leiemm/emm2025/viewer of robot v2.0/right.jpg

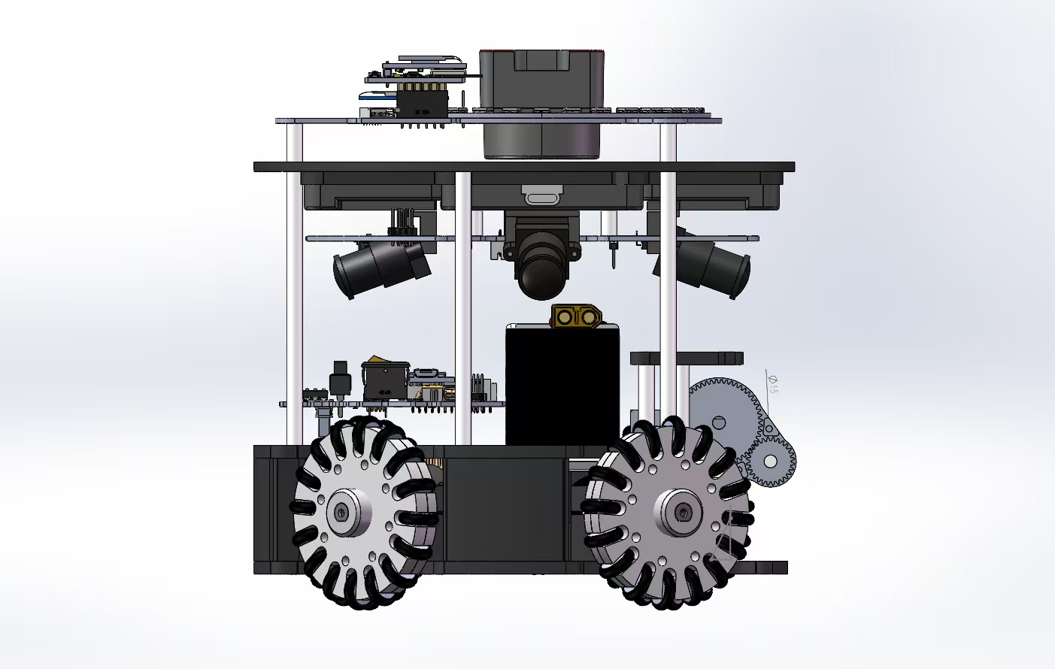
viewer of robot v2.0/right.jpg
