leiemm/emm2025/viewer of robot v2.0/overall.jpg

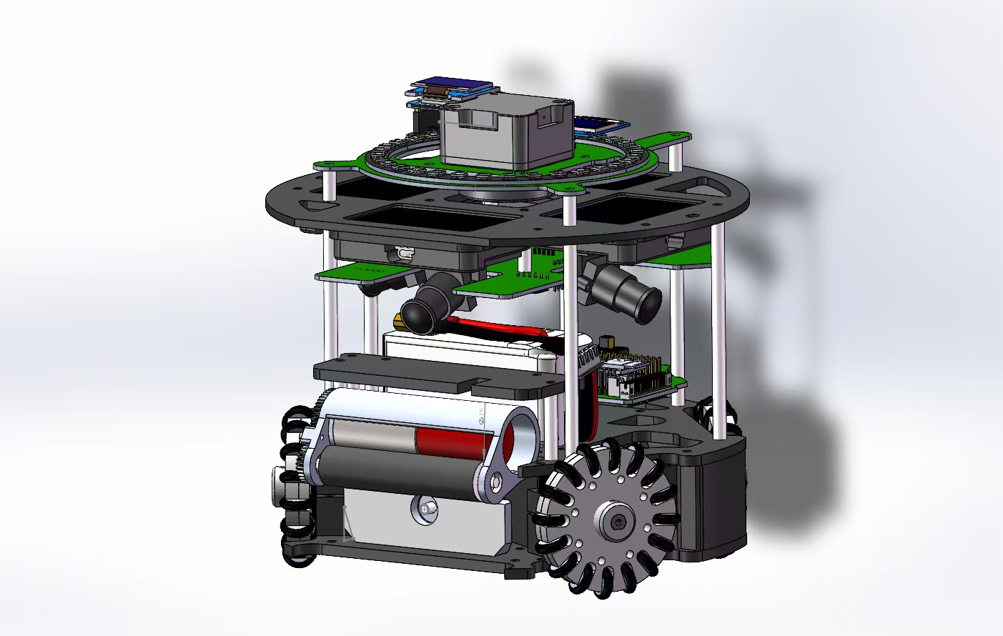
viewer of robot v2.0/overall.jpg
