leiemm/emm2025/poster/2026Korea.pdf

Others

# Soccer Vison

## E M M - S O C C E R

# E S C O L A D O S M O R A D O R E S D E M A C A U

Experiment / DATA

### Dribbler system

- Motor
- Micro Switch
- Gear *2
- Roller stick
- Rubber

### Positioning module

- YDLIDAR T-mini Plus

A

### Kicker system

- self made
electromagnet
- Custom MOSFET
Drive Circuit

When the robot touches our restricted area (sideline and restricted area), we decompose the speed into the x-axis and y-axis components, then cancel the out-ofbounds direction and re-synthesize to get the final speed.

# Out of bounds

Establish a circle as a defensive movement trajectory, and stay on the line connecting the ball and the center of the goal, limiting the opponent's maximum offensive space, with the head always facing outward.When the ball is stationary, it will dribble and then shoot the ball towards the goal.

# Deffense

攻

守

### Omni wheel *4

# Kicker system

## - Experiments & Data of Custom Electromagnet

# Omnidirectional positioning system

## -Use and development of lidar

We have achieved full-field localization based on LiDAR.
The system collects environmental point cloud data via
LiDAR and integrates gyroscope attitude data to correct each reflection point. All valid points are scored and voted on in both horizontal and vertical directions, and the four highest-scoring line segments are extracted to construct the complete field boundary. Simultaneously, LiDAR can detect scattered interference points in the field and calculate the real-time coordinates of enemy robots, providing reliable positional information for strategic decision-making. Our two robots communicate via Bluetooth, sharing their own status. By filtering out point cloud interference generated by the teammate robot, stable and accurate enemy coordinate localization is achieved.

# Long-distance vision system

## -Use of 4 cameras

# Speed control system

## -Use of PID Regulation

We conducted in-depth research on the coil and even built one ourselves. We found that increasing the current gain seemed to be greater than increasing the number of turns. Through derivation and testing, we determined the complete manufacturing process. Flat enameled wire was used for the winding to improve space utilization, and the coil resistance was verified using a milliohm meter after winding.
We developed a dedicated MOS drive circuit for this highpower coil. High-current MOSFETs have large parasitic capacitances; we added a push-pull circuit to accelerate the gate charging and discharging speed, avoiding MOSFET thermal breakdown due to switching losses during ramp-up. An external Schottky diode was used to prevent backflip, and VGS and current were monitored in real-time using an oscilloscope. A fuse was also installed for fault protection. Drawings and circuit diagrams are available on GitHub.
To standardize the experiments, we built a portable velocity measurement device. The flight time of a golf ball between two fixed laser beams was recorded, and its launch velocity was calculated to quantify the electromagnetic output performance. Currently, our electromagnet can achieve a velocity of approximately 3.8 m/s on this device.

### Battery

- Lipo(6s 22.2V 1450mah 180C)

### Motor system

- DJI robimaster M2006 motor *4
- DJI robimaster C615 ESC *4
- Adafruit CAN Pal *1

# Offense

### Main borad

- Teensy4.1

After holding the
ball, detect the
gap in the goal
and quickly shoot
the ball to the
goal.

E

F

G
H

I

We are a Macau team participating in soccer Vison. Our team this year consists of three high school students. This year, we have made major changes to our bodies. We hope to play exciting games on the field, communicate with other players, and make progress together.

Strategy

B

then turn around and shoot the goal.

C
D

### Visual system

- MaixCAM *4

ABSTRACT

LEI PUI WA
YE CHON KIT
SIT IONG / LAO SENG

Hardware/Software
Software
Electricity

## REGION

# MACAU, CHINA

## LEAGUE

Team members

### UI Circuit

- Ssd1306
- Ws2812 32bit

Overall

## Robot's Structure

Our robot design was completed in SOLIDWORKS, with the main body 3D printed using high-strength PETG wire. The PCB circuit design was completed in JLC EDA. We designed four cameras and used LiDAR for full-field anti-interference positioning and enemy detection, which enabled us to obtain good field data and more accurate sphere information, and to achieve diverse offensive and defensive postures.

Dribble along the
sideline, approach
the penalty area with
your back to the
opponent's
goalkeeper,

Bambu Lab
X1C

# Environment

GitHub
resources

Youtube channel:
https://youtube.com/@emm-soccer GitHub:
https://github.com/leiemm/emm2025

（The video can be found on our YouTube channel.）

Design / Algorithms

10-millisecond cycle
current detection

Hand-wound coil

drive circuit

Speed measuring device

Our robot is equipped with four cameras to deliver allround vision, expanding ball detection range and eliminating visual blind spots.
We use tangent circular trajectories to orbit the ball, enabling the shortest moving path while facing the goal. We set a virtual circle around the ball and compute distances and steering angles with right triangle geometry and inverse trigonometric functions. Calculation details are shown in the attached figure.

The robot’s field movement speed is regulated via PID control for both linear and angular velocity. When the robot moves forward without shortening its distance to the ball, the controller automatically increases speed to approach faster.
Meanwhile, variable dribble speed is implemented: the dribbler’s speed adjusts dynamically with the robot’s angular velocity to prevent ball loss during rotation.
Relationship Diagram of Dribbler Speed and Robot Motion Speed
