leiemm/emm2025/CAD drawing/3Ddrawing(robot)/PCB/Sub broad _robot2.0.png

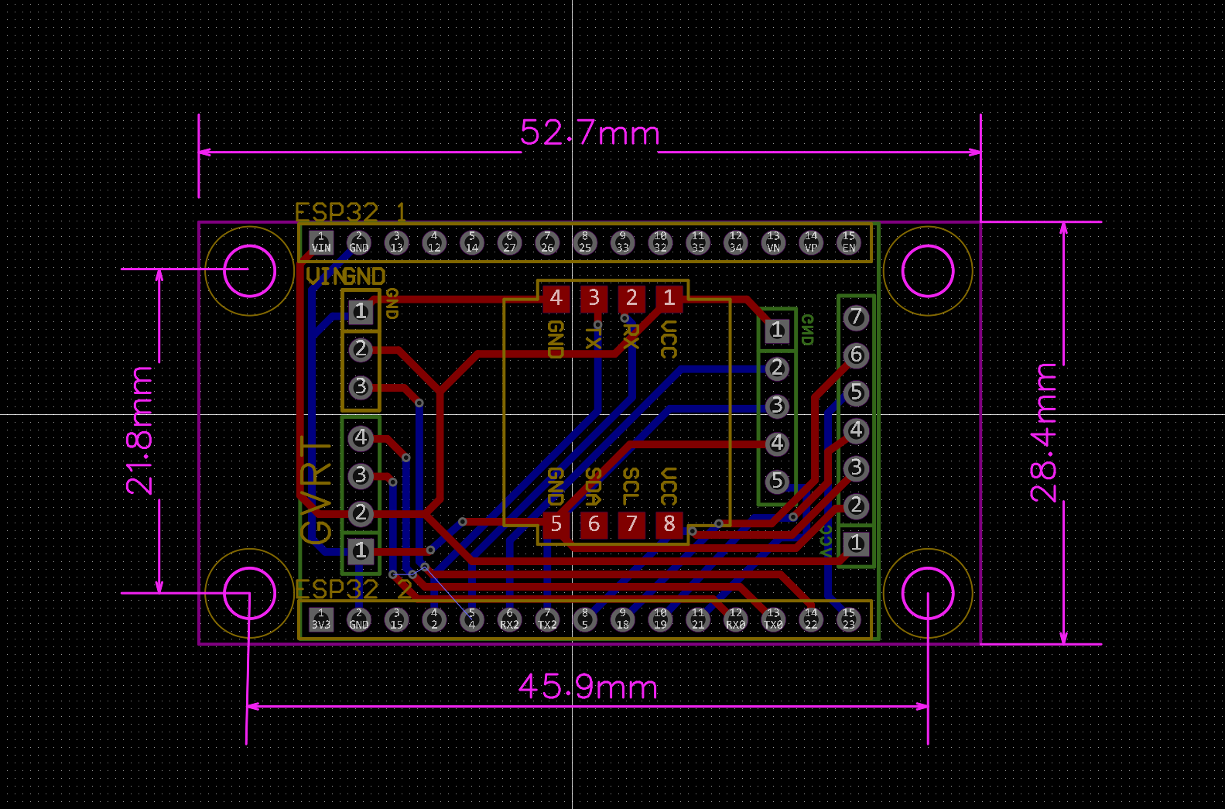
CAD drawing/3Ddrawing(robot)/PCB/Sub broad _robot2.0.png
