leiemm/emm2025/CAD drawing/3Ddrawing(robot)/PCB/sub broad_robot1.0(with camera).png

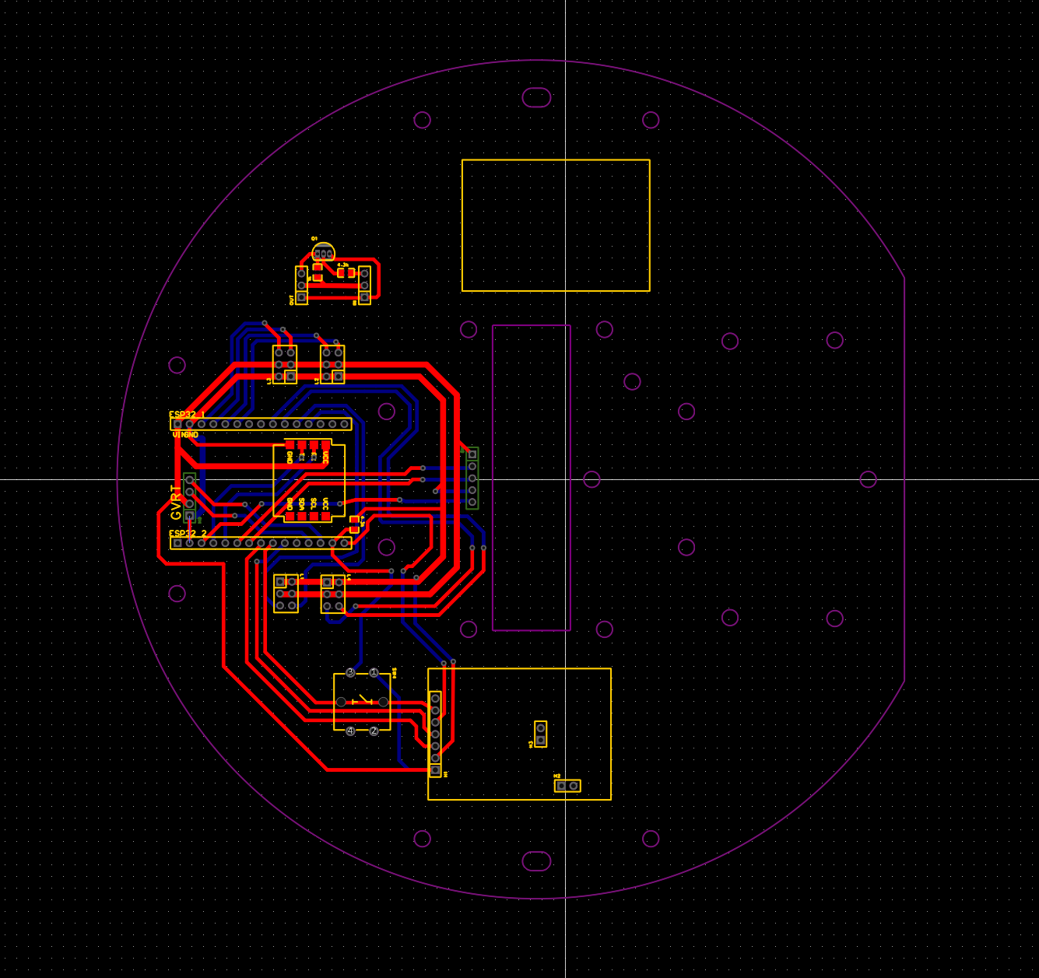
CAD drawing/3Ddrawing(robot)/PCB/sub broad_robot1.0(with camera).png
