leiemm/emm2025/viewer of robot v2.0/bottom.jpg

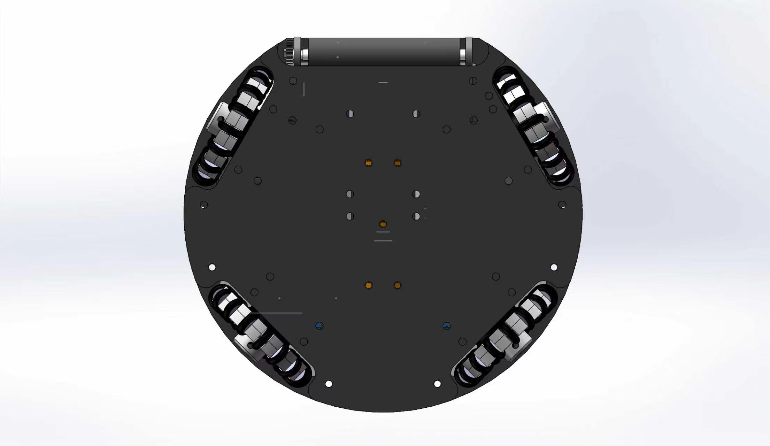
viewer of robot v2.0/bottom.jpg
