leiemm/emm2025/viewer of robot v2.0/front.jpg

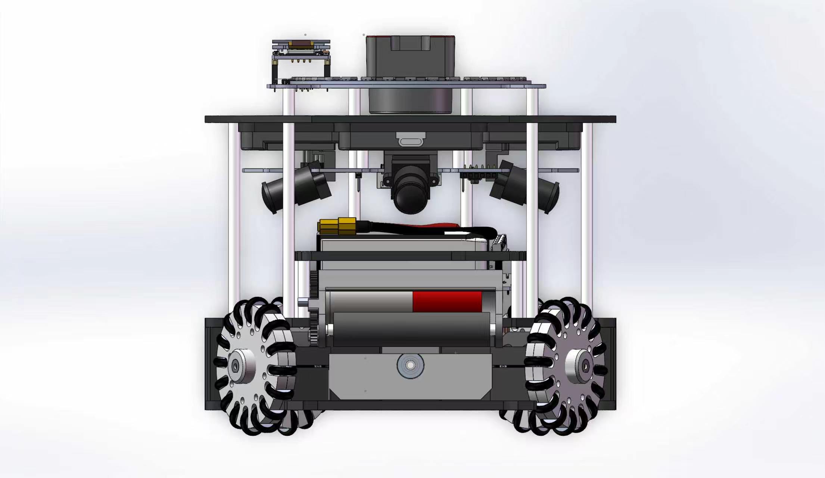
viewer of robot v2.0/front.jpg
