leiemm/emm2025/viewer of robot v2.0/left.jpg

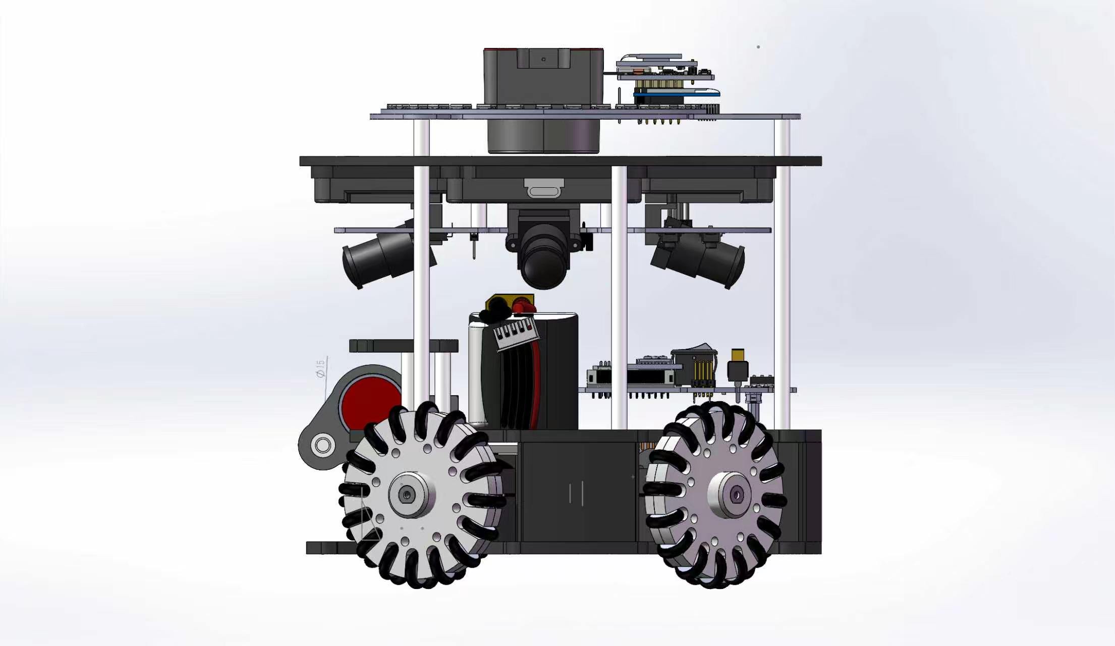
viewer of robot v2.0/left.jpg
