leiemm/emm2025/viewer of robot v2.0/top.jpg

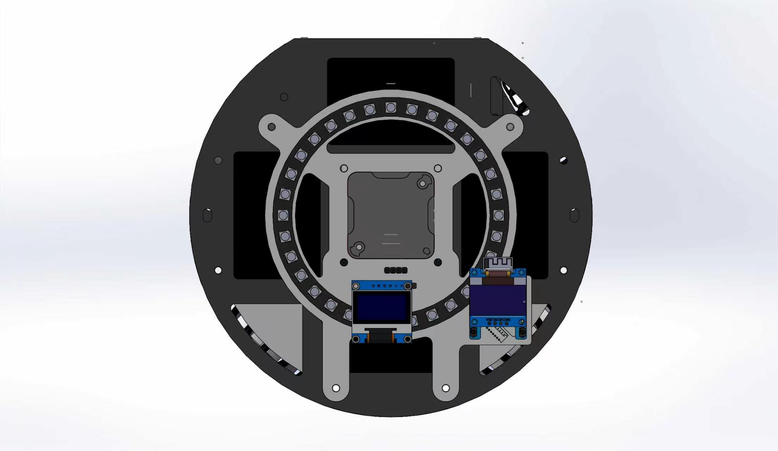
viewer of robot v2.0/top.jpg
