leiemm/emm2025/(list of files, cad)

Other CAD files:
CAD drawing/3Ddrawing(robot)/solidworks v2.0/part.SLDPRT
