leiemm/emm2025/schematics/mos.pdf

# MOS 输出指示LED

# 隔离驱动 GND

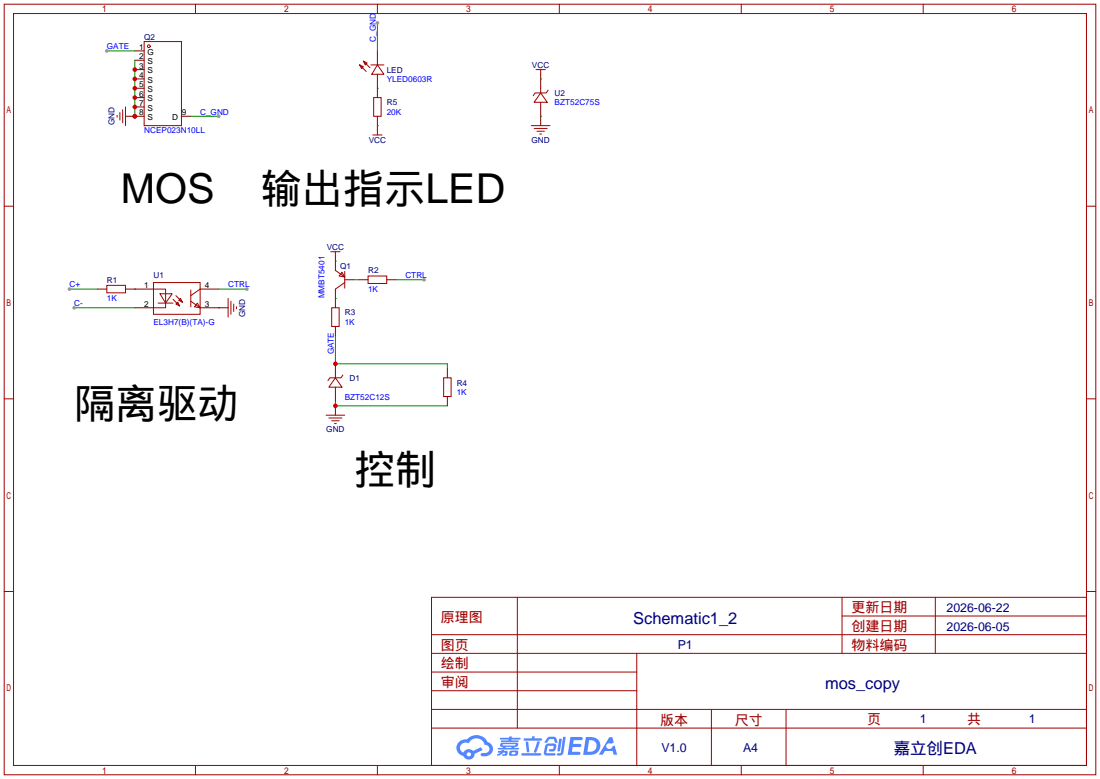
[picture p9: page 1]
