leiemm/emm2025/schematics/SCH_Schematic1_2026-06-24.pdf

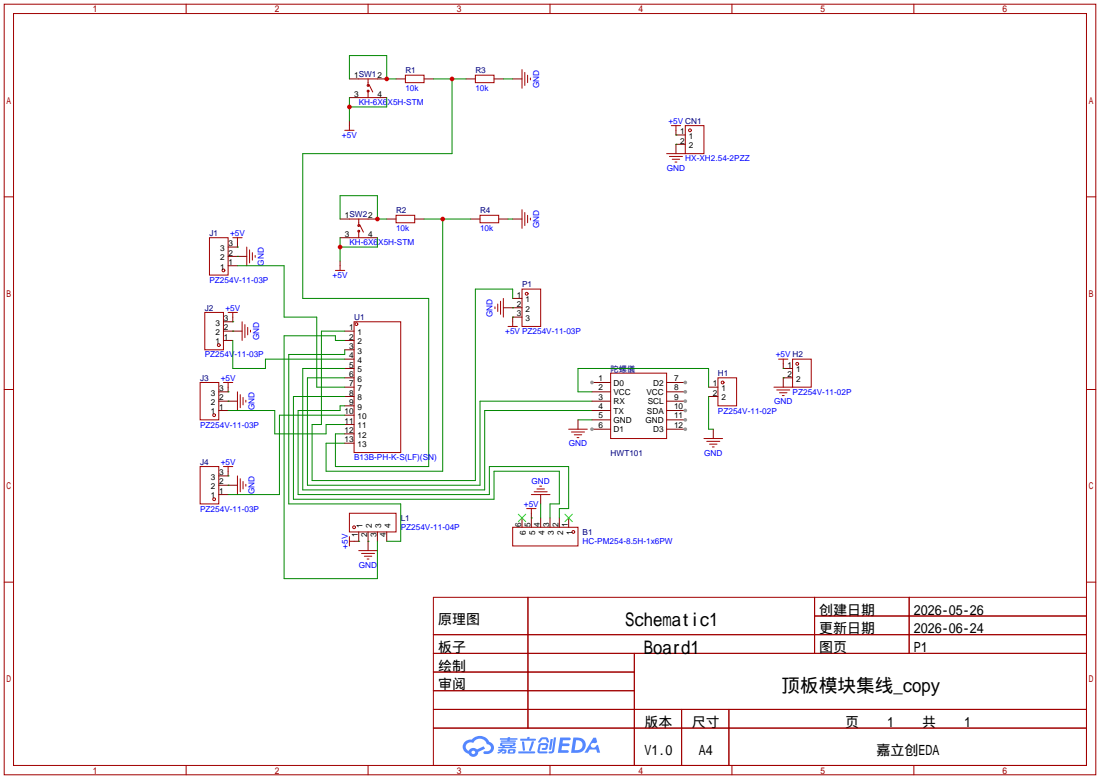
[picture p10: page 1]

原理图 | Schematic1 | 创建日期 | 2026-05-26

更新日期 | 2026-06-24

板子 | Board1 | 图页 | P1
绘制 | | 顶板模块集线_copy
审阅

V1.0 | A4 | 嘉立创EDA
