leiemm/emm2025/schematics/SCH_Schematic1_2026-06-27.pdf

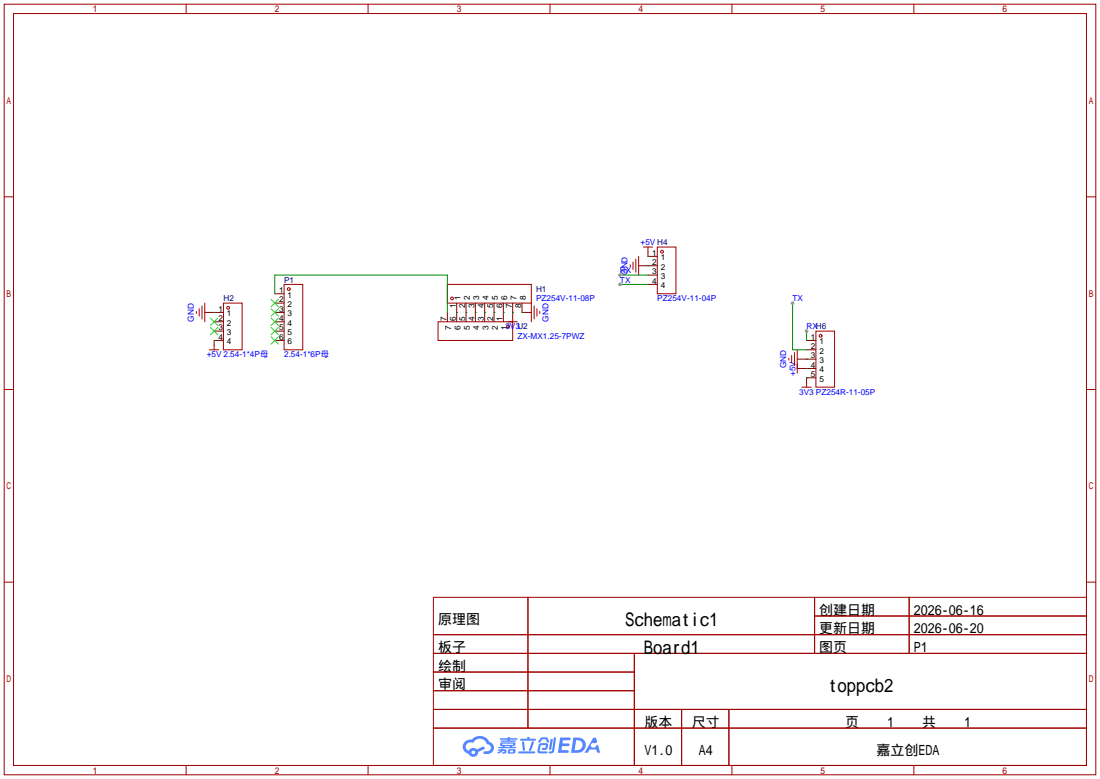
[picture p11: page 1]

原理图 | Schematic1 | 创建日期 | 2026-06-16

更新日期 | 2026-06-20

板子 | Board1 | 图页 | P1
绘制 | | toppcb2
审阅

V1.0 | A4 | 嘉立创EDA
