leiemm/emm2025/schematics/SCH_Schematic1a.pdf

# Teensy4.1 U1

## +5VGND

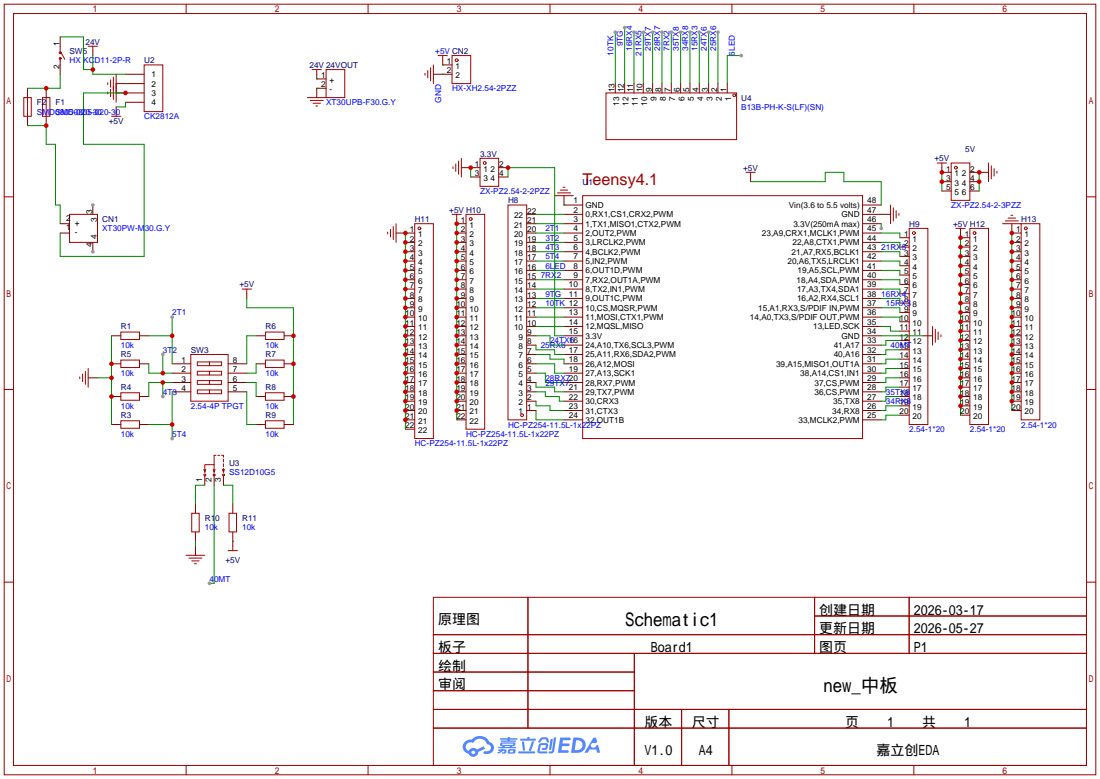
[picture p12: page 1]

原理图 | Schematic1 | 创建日期 | 2026-03-17

更新日期 | 2026-05-27

板子 | Board1 | 图页 | P1
绘制 | | new_中板
审阅

V1.0 | A4 | 嘉立创EDA
