leiemm/emm2025/schematics/ws2812.pdf

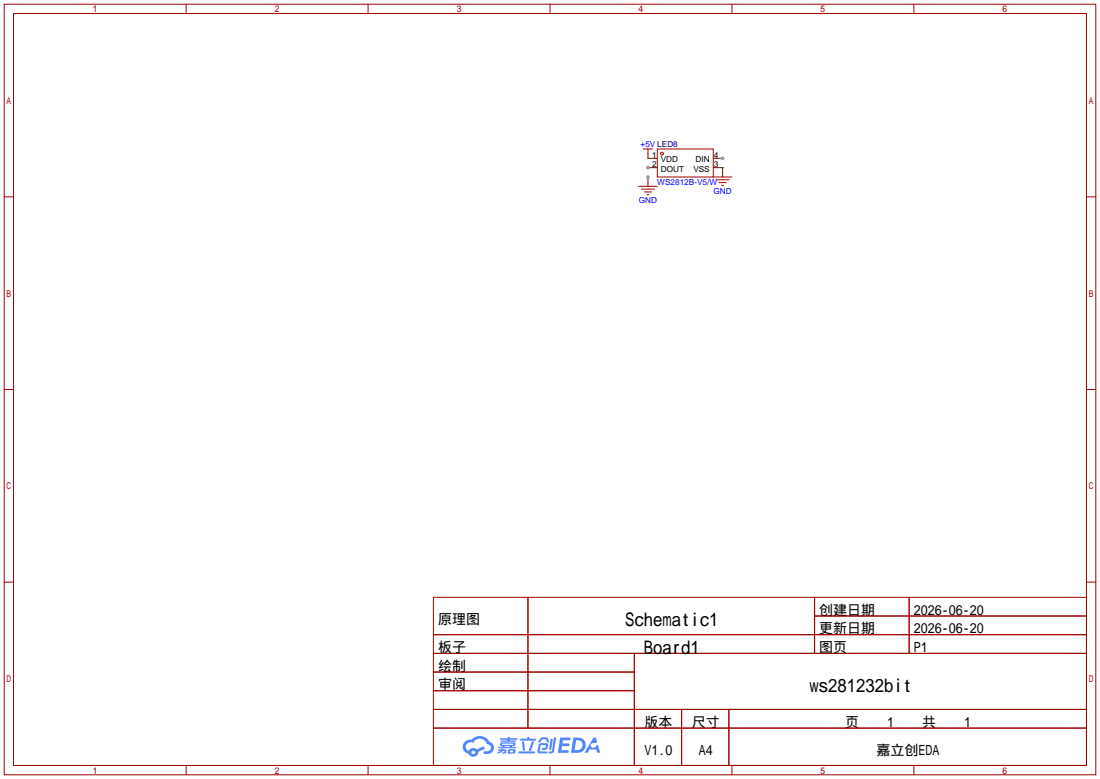
[picture p13: page 1]

原理图 | Schematic1 | 创建日期 | 2026-06-20

更新日期 | 2026-06-20

板子 | Board1 | 图页 | P1
绘制 | | ws281232bit
审阅

V1.0 | A4 | 嘉立创EDA
