leiemm/emm2025/(commit log)

2025-07-12 Create esp32_download
2026-06-30 Create schematic
    emm
2026-06-30 add part.SLDPRT to solidworks v2.0 via LFS
    [part.SLDPRT]
